hbanko/GearIndicator/Picture2.JPG

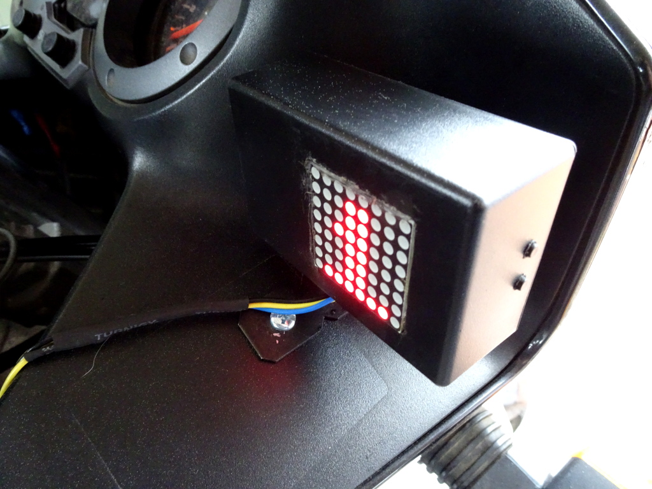
Picture2.JPG
