hbanko/GearIndicator/Picture1.JPG

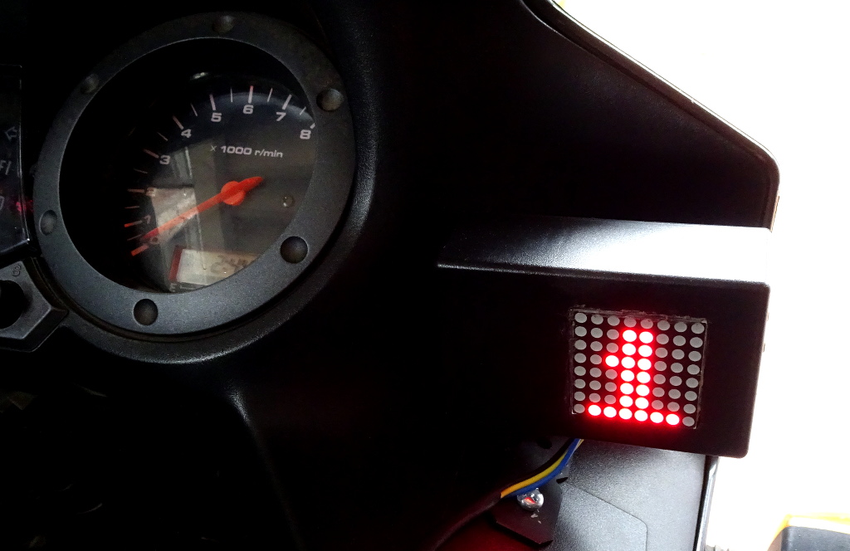
Picture1.JPG
