hbanko/GearIndicator/voltage_divider.png

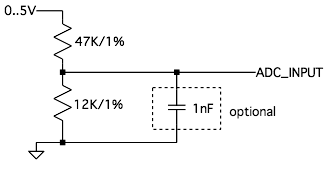
voltage_divider.png
