hbanko/GearIndicator/(commit log)

2018-10-01 Add files via upload
    GearIndicator initial release with OTA updates.
2018-10-04 Fixed WiFi bug
    Stuck at waiting for a WiFi connection outside of home WiFi.
    [GearIndicator_OTA.ino]
2018-10-05 Voltage Divider wiring diagram
2018-10-05 Picture of assembled and in use GearIndicator
2018-10-05 Added wiring
2018-10-05 Updated regulator
